mehmetkurt20/OpticalWirelessCommunication/schematics/rgbledindicator.png

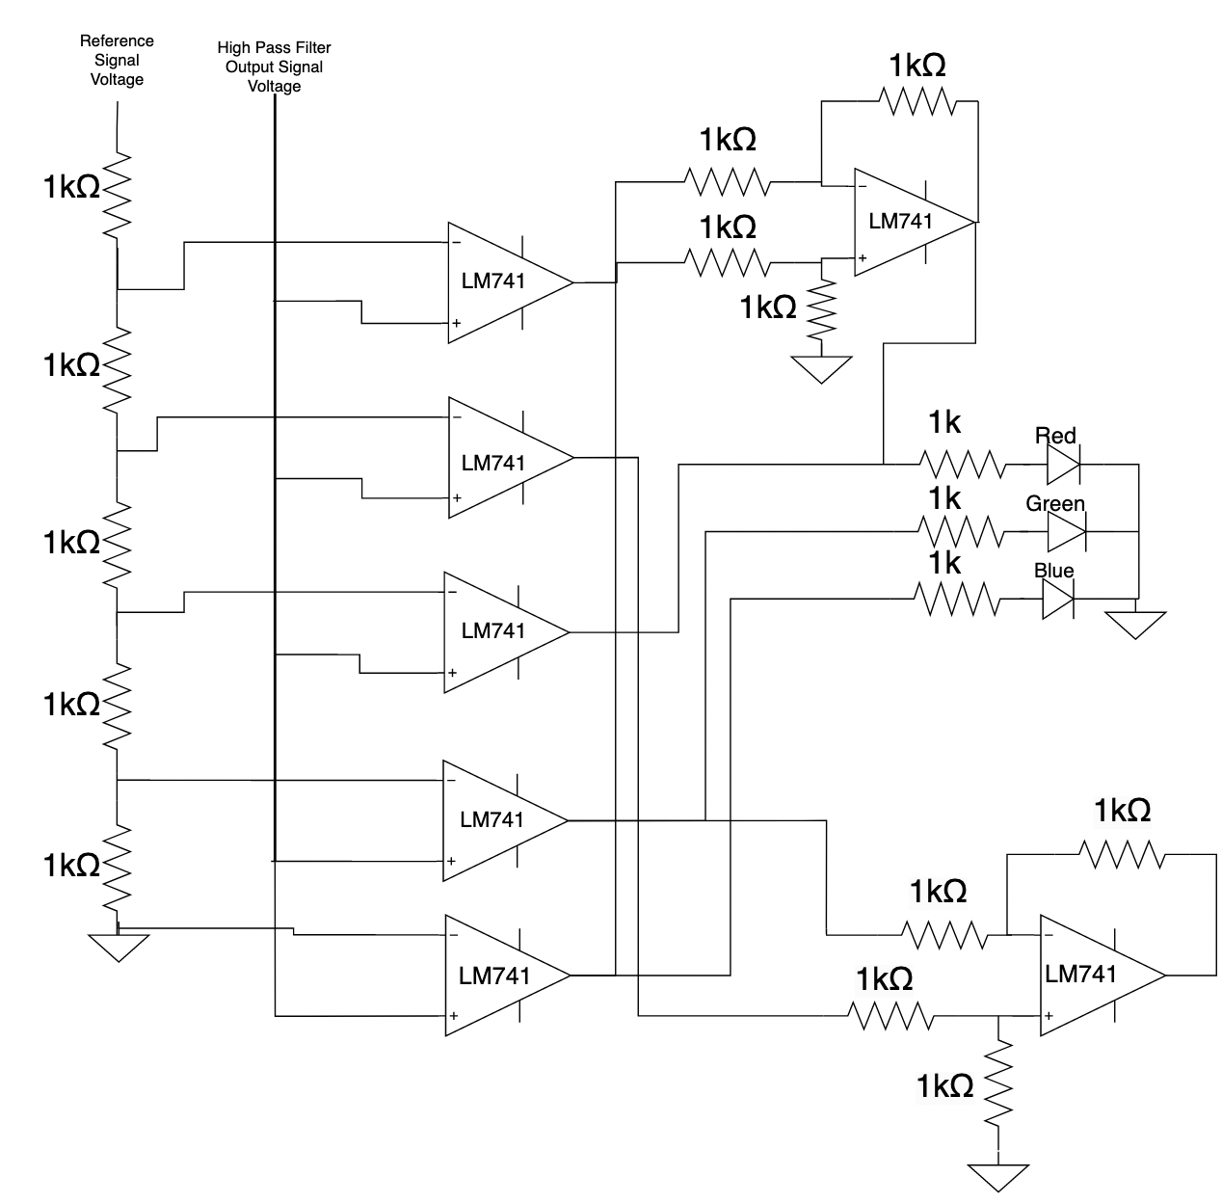
schematics/rgbledindicator.png
