mehmetkurt20/OpticalWirelessCommunication/simulations/Active High Pass Filter.asc

C1: cap; 0.1µf
R1: res; 0.125k
U1: UniversalOpAmp2
V1: voltage; 12
V2: voltage; -12
V3: voltage; ""; AC 1
Named nets: 0, 12V, -12V, V1, V2, Vout
.ac dec 10 1 100Meg
